Nich1con/microReader/PCB/mReader.png

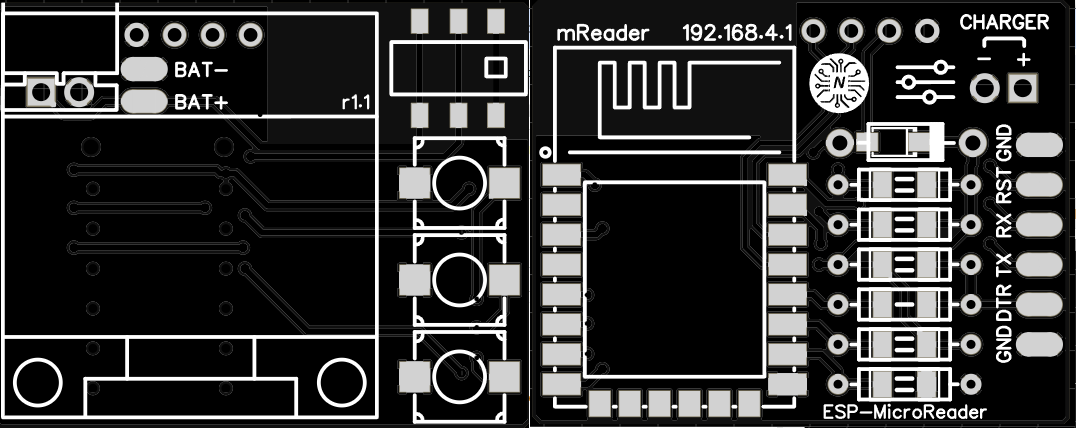
PCB/mReader.png
