Nich1con/microReader/schemes/MicroReader.png

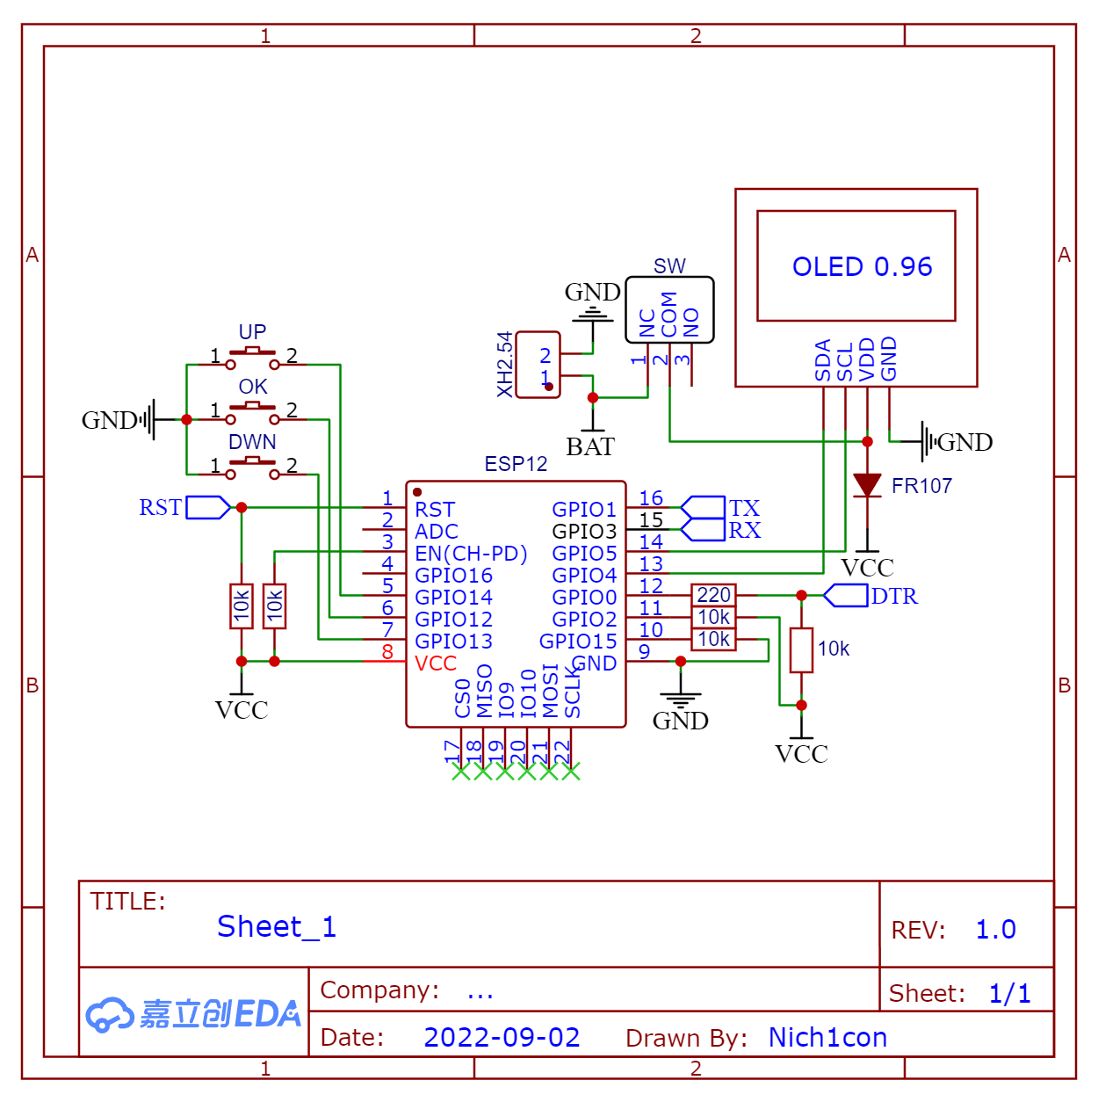
schemes/MicroReader.png
