Nich1con/microReader/manual/boardsets.png

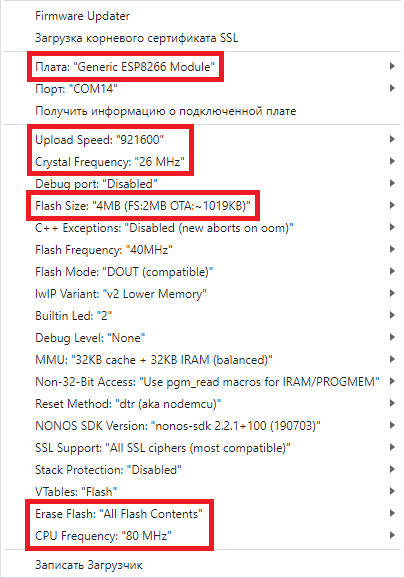
manual/boardsets.png
