Nich1con/microReader/manual/wireflash.png

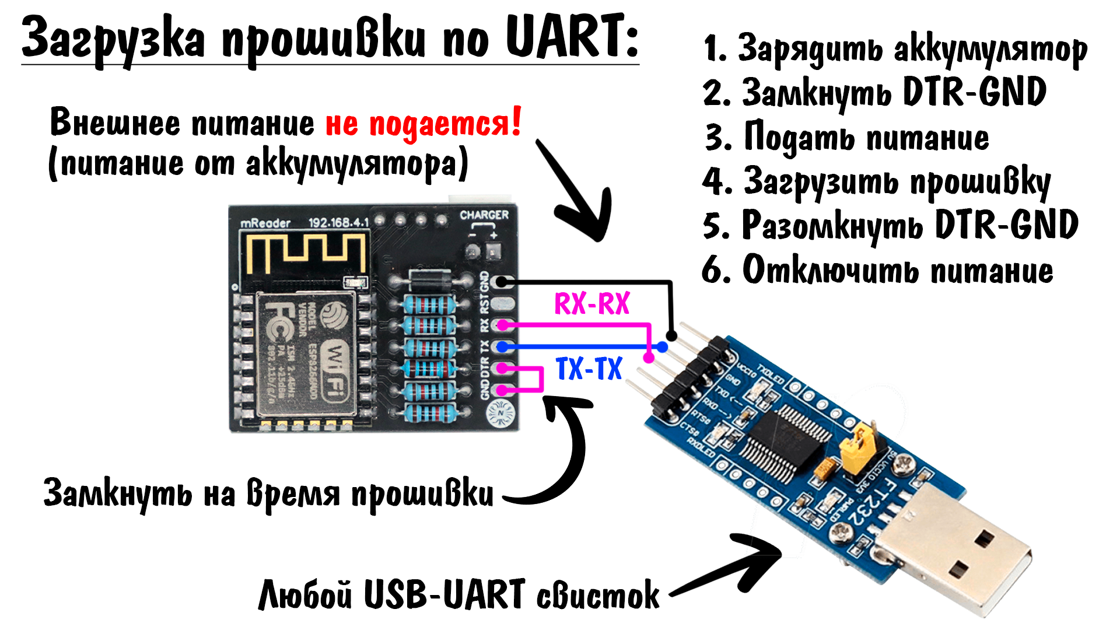
manual/wireflash.png
