Nich1con/microReader/test-files/гравитация.jpg

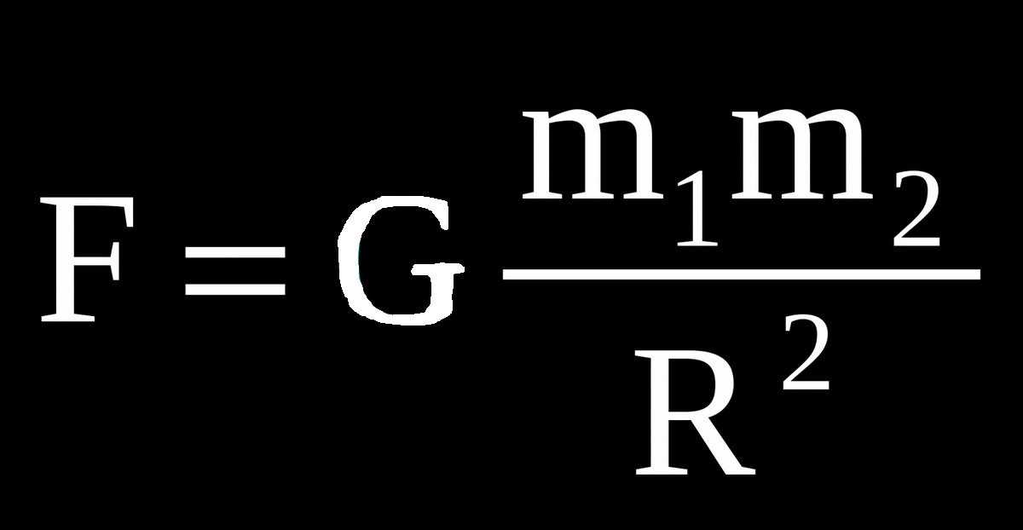
test-files/гравитация.jpg
