Nich1con/microReader/test-files/файл.jpg

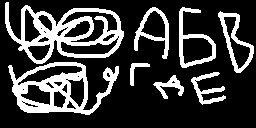
test-files/файл.jpg
