Nich1con/microReader/(threads)

Thread 1 (2023-06-23):

Текст в одну строку

vpuhoff, 2023-06-23:
Собрал версию из коммита 84136f26db3ba333e831ad605872763b49d404ec с библиотеками установленными из arduino ide, версии совпадают, но текст рисуется только в 1 строку первую, а не на весь экран, где может быть проблема? В скетче ничего не менял, все "из коробки".

vpuhoff, 2023-06-23:
На дефолтной прошивке из папки BIN такой проблемы нету.

vpuhoff, 2023-06-23:
Что интересно, когда заменил файлы библиотеки GyverOLED на те, что лежали в этой репе проблема ушла.

alex-kiev, 2023-08-01:
Та же проблема, спасибо за подсказку

Nich1con, 2024-04-05:
Проблема связана с новыми версиями GyverOLED - нужно использовать библиотеку из папки проекта

LogExE, 2024-04-11:
Лучше бы конечно написать Гайверу насчет этой проблемы. Это явно косяк в библиотеке олед, сам недавно с ним намучался))

Thread 2 (2023-06-26):

Compilation error: control reaches end of non-void function

olehdutko, 2023-06-26:
Arduino IDE 2.1.0
Compiler warnings: Default (or None)

COMPILATION ERROR at line 177:
Dir root = LittleFS.openDir("/");                 // Открываем директорию (корень)

cc1plus: some warnings being treated as errors
exit status 1
Compilation error: control reaches end of non-void function [-Werror=return-type]

aloyen07, 2023-07-14:
Проблему я решил. Просто прошил ESP'шку не скетчем, а готовым бинарным файлом. В firmware это есть.
Да, плохое решение. Но если не надо редактировать скетч, то сойдёт.

Но от создателя ждём фикса.

Compo728, 2023-09-13:
надо установить ядро для ESP версии 2.7.4 и ошибка пропадëт

Nich1con, 2024-04-05:
Для прошивки версии v1.0 нужно использовать ядро 2.7.4

Thread 3 (2023-07-26):

Добавь тетрис или пинг-понг

m-a-prod, 2023-07-26:
В школе-универе очень удобно будет коротать время на скучных уроках-парах =)
+ там же как раз 3 кнопки есть

Nich1con, 2024-04-05:
1-2 игры будут добавлены в прошивке v1.1

Thread 4 (2023-12-18):

Постоянно полный заряд

Sergulek35, 2023-12-18:
не правильно показывает уровень заряда! Всегда полный заряд!
Подскажите, была у кого такая проблема, и как с ней бороться!

Nich1con, 2024-04-05:
Единственный возможный вариант - брак АЦП в ESP8266

Sergulek35, 2024-04-05:
Спасибо, понял10:28, 5 апреля 2024 г., Nich1con ***@***.***>:
Единственный возможный вариант - брак АЦП в ESP8266

—Reply to this email directly, view it on GitHub, or unsubscribe.You are receiving this because you authored the thread.Message ID: ***@***.***>

Thread 5 (2023-12-24):

не работает быстрое листание вниз

nvlastik, 2023-12-24:
https://github.com/Nich1con/microReader/blob/84136f26db3ba333e831ad605872763b49d404ec/firmware/microReader-v1.0/microReader-v1.0.ino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

nvlastik, 2023-12-24:
пофикшено тут https://github.com/Nich1con/microReader/pull/6

Thread 8 (2024-04-06):

Проблема

Dogrundiy, 2024-04-06:
Я при первой настройке вай-фай мода, установил не тот вампир фай. А сейчас он не даёт зайти в настройки, пишет ошибку,  вместо имени сети пишет любые знаки от { до #. Помогите это исправить пожалуйста

Dogrundiy, 2024-04-06:
> Я при первой настройке вай-фай мода, установил не тот вай фай. А сейчас он не даёт зайти в AP мод, пишет ошибку, вместо имени сети пишет любые знаки от { до #. Помогите это исправить пожалуйста

LogExE, 2024-04-11:
Поищи переменную с ключем в коде прошивки, попробуй поменять ее значение и перепрошить читалку. Настройки сбросятся

Nich1con, 2024-04-22:
В версии прошивки 1.1 добавлена защита от подобных ситуаций. Новая прошивка доступна уже сейчас - обновляйтесь.

Thread 13 (2024-09-08):

Не инициализирован дисплей

Rad0n-arduino, 2024-09-08:
Дисплей не инициализирован. Хотя все дорожки я проверил с помощью мультметра, также дисплей был проверен с ардуино нано и работал, не могу понять почему не работает при подключение к плате. Если хотите помочь, пишите на почту: togas.airbag_0p@icloud.com спасибо за ответ)

Thread 14 (2024-11-09):

Помощь от гуру

VerchVS, 2024-11-09:
Добрый день!
Подскажите пожалуйста, если Вас не затруднит, какие строчки в коде файла библиотеки GyverOLED_fix.h необходимо поменять, чтобы работать с дисплеем SSD1306_96x16. (Для облегчения допустим оставить инициализацию 128х32, но переправить на 96х16)
Благодарю!

VerchVS, 2024-11-10:
Заменил дисплей на 128х32, но как я понимаю шпаргалка поддерживает только 128х64, не подскажите как настроить на 128х32?

Thread 15 (2024-12-06):

Кривые битмапы

Alexitinin, 2024-12-06:
При загрузке битмапа по инструкции он искривляется - через каждые 8 рядов следующие "съезжают" на 1 пиксель вправо, а в последних 8-ми рядах вообще отсутствуют крайние правые пиксели. Насколько я понял проблема где-то в парсере битмапов, потому что получилось исправить переносом в файле битмапа всех строчек в одну, хотя даже так те самые последние 8 пикселей по прежнему не отображаются. Не критично, но всё равно раздражает

Thread 16 (2025-01-17):

При форматировании, пропадает возможность загружать файлы

nowfow, 2025-01-17:
При форматировании, пропадает возможность загружать файлы. Возникает ошибка в браузере "Не удается получить доступ к сайту" при попытке загрузить файл

nowfow, 2025-01-17:
Нужно, после форматирования, сбросить настройки. Тогда файлы начинают загружаться

Closed 2025-01-17.
